cquca/nscscc_2018/soc_up/rtl/CONFREG/confreg.v

/*------------------------------------------------------------------------------
--------------------------------------------------------------------------------
Copyright (c) 2016, Loongson Technology Corporation Limited.

All rights reserved.

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
1. Redistributions of source code must retain the above copyright notice, this 
list of conditions and the following disclaimer.

2. Redistributions in binary form must reproduce the above copyright notice, 
this list of conditions and the following disclaimer in the documentation and/or
other materials provided with the distribution.

3. Neither the name of Loongson Technology Corporation Limited nor the names of 
its contributors may be used to endorse or promote products derived from this 
software without specific prior written permission.

THIS SOFTWARE IS PROVIDED BY THE COPYRIGHT HOLDERS AND CONTRIBUTORS "AS IS" AND 
ANY EXPRESS OR IMPLIED WARRANTIES, INCLUDING, BUT NOT LIMITED TO, THE IMPLIED 
WARRANTIES OF MERCHANTABILITY AND FITNESS FOR A PARTICULAR PURPOSE ARE 
DISCLAIMED. IN NO EVENT SHALL LOONGSON TECHNOLOGY CORPORATION LIMITED BE LIABLE
TO ANY PARTY FOR DIRECT, INDIRECT, INCIDENTAL, SPECIAL, EXEMPLARY, OR 
CONSEQUENTIAL DAMAGES (INCLUDING, BUT NOT LIMITED TO, PROCUREMENT OF SUBSTITUTE 
GOODS OR SERVICES; LOSS OF USE, DATA, OR PROFITS; OR BUSINESS INTERRUPTION) 
HOWEVER CAUSED AND ON ANY THEORY OF LIABILITY, WHETHER IN CONTRACT, STRICT 
LIABILITY, OR TORT (INCLUDING NEGLIGENCE OR OTHERWISE) ARISING IN ANY WAY OUT OF
THE USE OF THIS SOFTWARE, EVEN IF ADVISED OF THE POSSIBILITY OF SUCH DAMAGE.
--------------------------------------------------------------------------------
------------------------------------------------------------------------------*/

//*************************************************************************
//   > File Name   : confreg.v
//   > Description : Control module of 
//                   16 red leds, 2 green/red leds,
//                   7-segment display, 
//                   switchs, 
//                   key board,
//                   bottom STEP,
//                   timer.
//
//   > Author      : LOONGSON
//   > Date        : 2017-08-04
//*************************************************************************
`define RANDOM_SEED {7'b1010101,16'h0000}

`define CR0_ADDR       16'h8000   //32'hffff_8000 
`define CR1_ADDR       16'h8004   //32'hffff_8004 
`define CR2_ADDR       16'h8008   //32'hffff_8008 
`define CR3_ADDR       16'h800c   //32'hffff_800c 
`define CR4_ADDR       16'h8010   //32'hffff_8010 
`define CR5_ADDR       16'h8014   //32'hffff_8014 
`define CR6_ADDR       16'h8018   //32'hffff_8018 
`define CR7_ADDR       16'h801c   //32'hffff_801c 

`define LED_ADDR       16'hf000   //32'hffff_f000 
`define LED_RG0_ADDR   16'hf004   //32'hffff_f004 
`define LED_RG1_ADDR   16'hf008   //32'hffff_f008 
`define NUM_ADDR       16'hf010   //32'hffff_f010 
`define SWITCH_ADDR    16'hf020   //32'hffff_f020 
`define BTN_KEY_ADDR   16'hf024   //32'hffff_f024
`define BTN_STEP_ADDR  16'hf028   //32'hffff_f028
`define TIMER_ADDR     16'he000   //32'hffff_e000 

`define VIRTUAL_UART_ADDR 16'hfff0  //32'hffff_fff0
`define SIMU_FLAG_ADDR    16'hfff4  //32'hffff_fff4 
`define OPEN_TRACE_ADDR   16'hfff8  //32'hffff_fff8
`define NUM_MONITOR_ADDR  16'hfffc  //32'hffff_fffc
module confreg
#(parameter SIMULATION=1'b0)
(                     
    input             timer_clk,
    input             aclk,          
    input             aresetn,     
    // read and write from cpu
    //ar
    input  [3 :0] arid   ,
    input  [31:0] araddr ,
    input  [7 :0] arlen  ,
    input  [2 :0] arsize ,
    input  [1 :0] arburst,
    input  [1 :0] arlock ,
    input  [3 :0] arcache,
    input  [2 :0] arprot ,
    input         arvalid,
    output        arready,
    //r
    output [3 :0] rid    ,
    output [31:0] rdata  ,
    output [1 :0] rresp  ,
    output        rlast  ,
    output        rvalid ,
    input         rready ,
    //aw
    input  [3 :0] awid   ,
    input  [31:0] awaddr ,
    input  [7 :0] awlen  ,
    input  [2 :0] awsize ,
    input  [1 :0] awburst,
    input  [1 :0] awlock ,
    input  [3 :0] awcache,
    input  [2 :0] awprot ,
    input         awvalid,
    output        awready,
    //w
    input  [3 :0] wid    ,
    input  [31:0] wdata  ,
    input  [3 :0] wstrb  ,
    input         wlast  ,
    input         wvalid ,
    output        wready ,
    //b
    output [3 :0] bid    ,
    output [1 :0] bresp  ,
    output        bvalid ,
    input         bready ,

    //for lab6
    output     [4 :0] ram_random_mask  ,

    // read and write to device on board
    output     [15:0] led,          
    output     [1 :0] led_rg0,      
    output     [1 :0] led_rg1,      
    output reg [7 :0] num_csn,      
    output reg [6 :0] num_a_g,      
    input      [7 :0] switch,       
    output     [3 :0] btn_key_col,  
    input      [3 :0] btn_key_row,  
    input      [1 :0] btn_step      
);
    reg  [31:0] cr0;
    reg  [31:0] cr1;
    reg  [31:0] cr2;
    reg  [31:0] cr3;
    reg  [31:0] cr4;
    reg  [31:0] cr5;
    reg  [31:0] cr6;
    reg  [31:0] cr7;

    reg  [31:0] led_data;
    reg  [31:0] led_rg0_data;
    reg  [31:0] led_rg1_data;
    reg  [31:0] num_data;
    wire [31:0] switch_data;
    wire [31:0] btn_key_data;
    wire [31:0] btn_step_data;
    reg  [31:0] timer_r2;
    reg  [31:0] simu_flag;
    reg  [7 :0] virtual_uart_data;
    reg         open_trace;
    reg         num_monitor;
                        
//--------------------------{axi interface}begin-------------------------//
    reg busy,write,R_or_W;
    reg s_wready;

    wire ar_enter = arvalid & arready;
    wire r_retire = rvalid  & rready & rlast;
    wire aw_enter = awvalid & awready;
    wire w_enter  = wvalid  & wready & wlast;
    wire b_retire = bvalid  & bready;

    assign arready = ~busy & (!R_or_W| !awvalid);
    assign awready = ~busy & ( R_or_W| !arvalid);

    reg [3 :0] buf_id;
    reg [31:0] buf_addr;
    reg [7 :0] buf_len;
    reg [2 :0] buf_size;
    
    always @(posedge aclk)
    begin
        if(~aresetn) busy <= 1'b0;
        else if(ar_enter|aw_enter) busy <= 1'b1;
        else if(r_retire|b_retire) busy <= 1'b0;
    end
    
    always @(posedge aclk)
    begin
        if(~aresetn)
        begin
            R_or_W      <= 1'b0;
            buf_id      <= 4'b0;
            buf_addr    <= 32'b0;
            buf_len     <= 8'b0;
            buf_size    <= 3'b0;
        end
        else
        if(ar_enter | aw_enter)
        begin
            R_or_W      <= ar_enter;
            buf_id      <= ar_enter ? arid   : awid   ;
            buf_addr    <= ar_enter ? araddr : awaddr ;
            buf_len     <= ar_enter ? arlen  : awlen  ;
            buf_size    <= ar_enter ? arsize : awsize ;
        end
    end
    
    reg conf_wready_reg;
    assign wready = conf_wready_reg;
    always@(posedge aclk)
    begin
        if     (~aresetn       ) conf_wready_reg <= 1'b0;
        else if(aw_enter       ) conf_wready_reg <= 1'b1;
        else if(w_enter & wlast) conf_wready_reg <= 1'b0;
    end
    
    // read data has one cycle delay
    reg [31:0] conf_rdata_reg;
    reg        conf_rvalid_reg;
    reg        conf_rlast_reg;
    assign rdata  = conf_rdata_reg;
    assign rvalid = conf_rvalid_reg;
    assign rlast  = conf_rlast_reg;
    always @(posedge aclk)
    begin
        if(~aresetn)
        begin
            conf_rdata_reg  <= 32'd0;
            conf_rvalid_reg <= 1'd0;
            conf_rlast_reg  <= 1'd0;
        end
        else if(busy & R_or_W & !r_retire)
        begin
            conf_rvalid_reg <= 1'd1;
            conf_rlast_reg  <= 1'd1;
            case (buf_addr[15:0])
                `CR0_ADDR      : conf_rdata_reg <= cr0          ;
                `CR1_ADDR      : conf_rdata_reg <= cr1          ;
                `CR2_ADDR      : conf_rdata_reg <= cr2          ;
                `CR3_ADDR      : conf_rdata_reg <= cr3          ;
                `CR4_ADDR      : conf_rdata_reg <= cr4          ;
                `CR5_ADDR      : conf_rdata_reg <= cr5          ;
                `CR6_ADDR      : conf_rdata_reg <= cr6          ;
                `CR7_ADDR      : conf_rdata_reg <= cr7          ;
                `LED_ADDR      : conf_rdata_reg <= led_data     ;
                `LED_RG0_ADDR  : conf_rdata_reg <= led_rg0_data ;
                `LED_RG1_ADDR  : conf_rdata_reg <= led_rg1_data ;
                `NUM_ADDR      : conf_rdata_reg <= num_data     ;
                `SWITCH_ADDR   : conf_rdata_reg <= switch_data  ;
                `BTN_KEY_ADDR  : conf_rdata_reg <= btn_key_data ;
                `BTN_STEP_ADDR : conf_rdata_reg <= btn_step_data;
                `TIMER_ADDR    : conf_rdata_reg <= timer_r2     ;
                `SIMU_FLAG_ADDR: conf_rdata_reg <= simu_flag    ;
                `VIRTUAL_UART_ADDR : conf_rdata_reg <= {24'd0,virtual_uart_data} ;
                `OPEN_TRACE_ADDR : conf_rdata_reg <= {31'd0,open_trace} ;
                `NUM_MONITOR_ADDR: conf_rdata_reg <= {31'd0,num_monitor} ;
                default        : conf_rdata_reg <= 32'd0;
            endcase
        end
        else if(r_retire)
        begin
            conf_rvalid_reg <= 1'b0;
        end
    end

    //conf write, only support a word write
    wire        conf_we;
    wire [31:0] conf_addr;
    wire [31:0] conf_wdata;
    assign conf_we   = w_enter;
    assign conf_addr = buf_addr;
    assign conf_wdata= wdata;

    reg conf_bvalid_reg;
    assign bvalid = conf_bvalid_reg;
    always @(posedge aclk)   
    begin
        if     (~aresetn) conf_bvalid_reg <= 1'b0;
        else if(w_enter ) conf_bvalid_reg <= 1'b1;
        else if(b_retire) conf_bvalid_reg <= 1'b0;
    end

    assign rid   = buf_id;
    assign bid   = buf_id;
    assign bresp = 2'b0;
    assign rresp = 2'b0;
//---------------------------{axi interface}end--------------------------//

//-------------------------{confreg register}begin-----------------------//
wire write_cr0 = conf_we & (conf_addr[15:0]==`CR0_ADDR);
wire write_cr1 = conf_we & (conf_addr[15:0]==`CR1_ADDR);
wire write_cr2 = conf_we & (conf_addr[15:0]==`CR2_ADDR);
wire write_cr3 = conf_we & (conf_addr[15:0]==`CR3_ADDR);
wire write_cr4 = conf_we & (conf_addr[15:0]==`CR4_ADDR);
wire write_cr5 = conf_we & (conf_addr[15:0]==`CR5_ADDR);
wire write_cr6 = conf_we & (conf_addr[15:0]==`CR6_ADDR);
wire write_cr7 = conf_we & (conf_addr[15:0]==`CR7_ADDR);
always @(posedge aclk)
begin
    cr0 <= !aresetn    ? 32'd0      :
           write_cr0 ? conf_wdata : cr0;
    cr1 <= !aresetn    ? 32'd0      :
           write_cr1 ? conf_wdata : cr1;
    cr2 <= !aresetn    ? 32'd0      :
           write_cr2 ? conf_wdata : cr2;
    cr3 <= !aresetn    ? 32'd0      :
           write_cr3 ? conf_wdata : cr3;
    cr4 <= !aresetn    ? 32'd0      :
           write_cr4 ? conf_wdata : cr4;
    cr5 <= !aresetn    ? 32'd0      :
           write_cr5 ? conf_wdata : cr5;
    cr6 <= !aresetn    ? 32'd0      :
           write_cr6 ? conf_wdata : cr6;
    cr7 <= !aresetn    ? 32'd0      :
           write_cr7 ? conf_wdata : cr7;
end
//--------------------------{confreg register}end------------------------//

//-------------------------------{timer}begin----------------------------//
reg         write_timer_begin,write_timer_begin_r1, write_timer_begin_r2,write_timer_begin_r3;
reg         write_timer_end_r1, write_timer_end_r2;
reg  [31:0] conf_wdata_r, conf_wdata_r1,conf_wdata_r2;

reg  [31:0] timer_r1;
reg  [31:0] timer;

wire write_timer = conf_we & (conf_addr[15:0]==`TIMER_ADDR);
always @(posedge aclk)
begin
    if (!aresetn)
    begin
        write_timer_begin <= 1'b0;
    end 
    else if (write_timer)
    begin
        write_timer_begin <= 1'b1;
        conf_wdata_r      <= conf_wdata;
    end 
    else if (write_timer_end_r2)
    begin
        write_timer_begin <= 1'b0;
    end 

    write_timer_end_r1 <= write_timer_begin_r2;
    write_timer_end_r2 <= write_timer_end_r1;
end

always @(posedge timer_clk)
begin
    write_timer_begin_r1 <= write_timer_begin;
    write_timer_begin_r2 <= write_timer_begin_r1;
    write_timer_begin_r3 <= write_timer_begin_r2;
    conf_wdata_r1        <= conf_wdata_r;
    conf_wdata_r2        <= conf_wdata_r1;

    if(!aresetn)
    begin
        timer <= 32'd0;
    end
    else if (write_timer_begin_r2 && !write_timer_begin_r3)
    begin
        timer <= conf_wdata_r2[31:0];
    end
    else
    begin
        timer <= timer + 1'b1;
    end
end

always @(posedge aclk)
begin
    timer_r1 <= timer;
    timer_r2 <= timer_r1;
end
//--------------------------------{timer}end-----------------------------//

//--------------------------{simulation flag}begin-----------------------//
always @(posedge aclk)
begin
    if(!aresetn)
    begin
        simu_flag <= {32{SIMULATION}};
    end
end
//---------------------------{simulation flag}end------------------------//

//-----------------------------{open trace}begin-------------------------//
wire write_open_trace = conf_we & (conf_addr[15:0]==`OPEN_TRACE_ADDR);
always @(posedge aclk)
begin
    if(!aresetn)
    begin
        open_trace <= 1'b1;
    end
    else if(write_open_trace)
    begin
        open_trace <= conf_wdata[0];
    end
end
//-----------------------------{open trace}end---------------------------//

//----------------------------{num monitor}begin-------------------------//
wire write_num_monitor = conf_we & (conf_addr[15:0]==`NUM_MONITOR_ADDR);
always @(posedge aclk)
begin
    if(!aresetn)
    begin
        num_monitor <= 1'b1;
    end
    else if(write_num_monitor)
    begin
        num_monitor <= conf_wdata[0];
    end
end
//----------------------------{num monitor}end---------------------------//

//---------------------------{virtual uart}begin-------------------------//
wire [7:0] write_uart_data;
wire write_uart_valid  = conf_we & (conf_addr[15:0]==`VIRTUAL_UART_ADDR);
assign write_uart_data = conf_wdata[7:0];
always @(posedge aclk)
begin
    if(!aresetn)
    begin
        virtual_uart_data <= 8'd0;
    end
    else if(write_uart_valid)
    begin
        virtual_uart_data <= write_uart_data;
    end
end
//----------------------------{virtual uart}end--------------------------//

//--------------------------{axirandom mask}begin------------------------//
wire [15:0] led_r_n;
assign led_r_n = {~led[0],~led[1],~led[2],~led[3],
                  ~led[4],~led[5],~led[6],~led[7],
				  ~led[8],~led[9],~led[10],~led[11],
				  ~led[12],~led[13],~led[14],~led[15]};

reg [22:0] pseudo_random_23;
always @ (posedge aclk)
begin
   if (!aresetn || btn_step_data[0])
       //pseudo_random_23 <= simu_flag ? `RANDOM_SEED : {7'b1010101,led_r_n};
       pseudo_random_23 <= {7'b1010101,led_r_n};
   else
       pseudo_random_23 <= {pseudo_random_23[21:0],pseudo_random_23[22] ^ pseudo_random_23[17]};
end
assign ram_random_mask[0] = pseudo_random_23[10] & pseudo_random_23[20];
assign ram_random_mask[1] = pseudo_random_23[ 9] & pseudo_random_23[15];
assign ram_random_mask[2] = pseudo_random_23[ 8] ^ pseudo_random_23[22];
assign ram_random_mask[3] = pseudo_random_23[ 7] & pseudo_random_23[19];
assign ram_random_mask[4] = pseudo_random_23[ 6] ^ pseudo_random_23[16];

//---------------------------{axirandom mask}end-------------------------//

//--------------------------------{led}begin-----------------------------//
//led display
//led_data[31:0]
wire write_led = conf_we & (conf_addr[15:0]==`LED_ADDR);
//for lab6
//assign led = led_data[15:0];
assign led = {{2{switch[7]}},{2{switch[6]}},{2{switch[5]}},{2{switch[4]}},
              {2{switch[3]}},{2{switch[2]}},{2{switch[1]}},{2{switch[0]}}};
always @(posedge aclk)
begin
    if(!aresetn)
    begin
        led_data <= 32'h0;
    end
    else if(write_led)
    begin
        led_data <= conf_wdata[31:0];
    end
end
//---------------------------------{led}end------------------------------//

//-------------------------------{switch}begin---------------------------//
//switch data
//switch_data[7:0]
assign switch_data = {24'd0,switch};
//--------------------------------{switch}end----------------------------//

//------------------------------{btn key}begin---------------------------//
//btn key data
reg [15:0] btn_key_r;
assign btn_key_data = {16'd0,btn_key_r};

//state machine
reg  [2:0] state;
wire [2:0] next_state;

//eliminate jitter
reg        key_flag;
reg [19:0] key_count;
reg [ 3:0] state_count;
wire key_start = (state==3'b000) && !(&btn_key_row);
wire key_end   = (state==3'b111) &&  (&btn_key_row);
wire key_sample= key_count[19];
always @(posedge aclk)
begin
    if(!aresetn)
    begin
        key_flag <= 1'd0;
    end
    else if (key_sample && state_count[3]) 
    begin
        key_flag <= 1'b0;
    end
    else if( key_start || key_end )
    begin
        key_flag <= 1'b1;
    end

    if(!aresetn || !key_flag)
    begin
        key_count <= 20'd0;
    end
    else
    begin
        key_count <= key_count + 1'b1;
    end
end

always @(posedge aclk)
begin
    if(!aresetn || state_count[3])
    begin
        state_count <= 4'd0;
    end
    else
    begin
        state_count <= state_count + 1'b1;
    end
end

always @(posedge aclk)
begin
    if(!aresetn)
    begin
        state <= 3'b000;
    end
    else if (state_count[3])
    begin
        state <= next_state;
    end
end

assign next_state = (state == 3'b000) ? ( (key_sample && !(&btn_key_row)) ? 3'b001 : 3'b000 ) :
                    (state == 3'b001) ? (                !(&btn_key_row)  ? 3'b111 : 3'b010 ) :
                    (state == 3'b010) ? (                !(&btn_key_row)  ? 3'b111 : 3'b011 ) :
                    (state == 3'b011) ? (                !(&btn_key_row)  ? 3'b111 : 3'b100 ) :
                    (state == 3'b100) ? (                !(&btn_key_row)  ? 3'b111 : 3'b000 ) :
                    (state == 3'b111) ? ( (key_sample &&  (&btn_key_row)) ? 3'b000 : 3'b111 ) :
                                                                                        3'b000;
assign btn_key_col = (state == 3'b000) ? 4'b0000:
                     (state == 3'b001) ? 4'b1110:
                     (state == 3'b010) ? 4'b1101:
                     (state == 3'b011) ? 4'b1011:
                     (state == 3'b100) ? 4'b0111:
                                         4'b0000;
wire [15:0] btn_key_tmp;
always @(posedge aclk) begin
    if(!aresetn) begin
        btn_key_r   <= 16'd0;
    end
    else if(next_state==3'b000)
    begin
        btn_key_r   <=16'd0;
    end
    else if(next_state == 3'b111 && state != 3'b111) begin
        btn_key_r   <= btn_key_tmp;
    end
end

assign btn_key_tmp = (state == 3'b001)&(btn_key_row == 4'b1110) ? 16'h0001:
                     (state == 3'b001)&(btn_key_row == 4'b1101) ? 16'h0010:
                     (state == 3'b001)&(btn_key_row == 4'b1011) ? 16'h0100:
                     (state == 3'b001)&(btn_key_row == 4'b0111) ? 16'h1000:
                     (state == 3'b010)&(btn_key_row == 4'b1110) ? 16'h0002:
                     (state == 3'b010)&(btn_key_row == 4'b1101) ? 16'h0020:
                     (state == 3'b010)&(btn_key_row == 4'b1011) ? 16'h0200:
                     (state == 3'b010)&(btn_key_row == 4'b0111) ? 16'h2000:
                     (state == 3'b011)&(btn_key_row == 4'b1110) ? 16'h0004:
                     (state == 3'b011)&(btn_key_row == 4'b1101) ? 16'h0040:
                     (state == 3'b011)&(btn_key_row == 4'b1011) ? 16'h0400:
                     (state == 3'b011)&(btn_key_row == 4'b0111) ? 16'h4000:
                     (state == 3'b100)&(btn_key_row == 4'b1110) ? 16'h0008:
                     (state == 3'b100)&(btn_key_row == 4'b1101) ? 16'h0080:
                     (state == 3'b100)&(btn_key_row == 4'b1011) ? 16'h0800:
                     (state == 3'b100)&(btn_key_row == 4'b0111) ? 16'h8000:16'h0000;
//-------------------------------{btn key}end----------------------------//

//-----------------------------{btn step}begin---------------------------//
//btn step data
reg btn_step0_r; //0:press
reg btn_step1_r; //0:press
assign btn_step_data = {30'd0,~btn_step0_r,~btn_step1_r}; //1:press

//-----step0
//eliminate jitter
reg        step0_flag;
reg [19:0] step0_count;
wire step0_start = btn_step0_r && !btn_step[0];
wire step0_end   = !btn_step0_r && btn_step[0];
wire step0_sample= step0_count[19];
always @(posedge aclk)
begin
    if(!aresetn)
    begin
        step0_flag <= 1'd0;
    end
    else if (step0_sample) 
    begin
        step0_flag <= 1'b0;
    end
    else if( step0_start || step0_end )
    begin
        step0_flag <= 1'b1;
    end

    if(!aresetn || !step0_flag)
    begin
        step0_count <= 20'd0;
    end
    else
    begin
        step0_count <= step0_count + 1'b1;
    end

    if(!aresetn)
    begin
        btn_step0_r <= 1'b1;
    end
    else if(step0_sample)
    begin
        btn_step0_r <= btn_step[0];
    end
end

//-----step1
//eliminate jitter
reg        step1_flag;
reg [19:0] step1_count;
wire step1_start = btn_step1_r && !btn_step[1];
wire step1_end   = !btn_step1_r && btn_step[1];
wire step1_sample= step1_count[19];
always @(posedge aclk)
begin
    if(!aresetn)
    begin
        step1_flag <= 1'd0;
    end
    else if (step1_sample) 
    begin
        step1_flag <= 1'b0;
    end
    else if( step1_start || step1_end )
    begin
        step1_flag <= 1'b1;
    end

    if(!aresetn || !step1_flag)
    begin
        step1_count <= 20'd0;
    end
    else
    begin
        step1_count <= step1_count + 1'b1;
    end

    if(!aresetn)
    begin
        btn_step1_r <= 1'b1;
    end
    else if(step1_sample)
    begin
        btn_step1_r <= btn_step[1];
    end
end
//------------------------------{btn step}end----------------------------//

//-------------------------------{led rg}begin---------------------------//
//led_rg0_data[31:0]  led_rg0_data[31:0]
//bfd0_f010           bfd0_f014
wire write_led_rg0 = conf_we & (conf_addr[15:0]==`LED_RG0_ADDR);
wire write_led_rg1 = conf_we & (conf_addr[15:0]==`LED_RG1_ADDR);
assign led_rg0 = led_rg0_data[1:0];
assign led_rg1 = led_rg1_data[1:0];
always @(posedge aclk)
begin
    if(!aresetn)
    begin
        led_rg0_data <= 32'h0;
    end
    else if(write_led_rg0)
    begin
        led_rg0_data <= conf_wdata[31:0];
    end

    if(!aresetn)
    begin
        led_rg1_data <= 32'h0;
    end
    else if(write_led_rg1)
    begin
        led_rg1_data <= conf_wdata[31:0];
    end
end
//--------------------------------{led rg}end----------------------------//

//---------------------------{digital number}begin-----------------------//
//digital number display
//num_data[31:0]
wire write_num = conf_we & (conf_addr[15:0]==`NUM_ADDR);
always @(posedge aclk)
begin
    if(!aresetn)
    begin
        num_data <= 32'h0;
    end
    else if(write_num)
    begin
        num_data <= conf_wdata[31:0];
    end
end


reg [19:0] count;
always @(posedge aclk)
begin
    if(!aresetn)
    begin
        count <= 20'd0;
    end
    else
    begin
        count <= count + 1'b1;
    end
end
//scan data
reg [3:0] scan_data;
always @ ( posedge aclk )  
begin
    if ( !aresetn )
    begin
        scan_data <= 32'd0;  
        num_csn   <= 8'b1111_1111;
    end
    else
    begin
        case(count[19:17])
            3'b000 : scan_data <= num_data[31:28];
            3'b001 : scan_data <= num_data[27:24];
            3'b010 : scan_data <= num_data[23:20];
            3'b011 : scan_data <= num_data[19:16];
            3'b100 : scan_data <= num_data[15:12];
            3'b101 : scan_data <= num_data[11: 8];
            3'b110 : scan_data <= num_data[7 : 4];
            3'b111 : scan_data <= num_data[3 : 0];
        endcase

        case(count[19:17])
            3'b000 : num_csn <= 8'b0111_1111;
            3'b001 : num_csn <= 8'b1011_1111;
            3'b010 : num_csn <= 8'b1101_1111;
            3'b011 : num_csn <= 8'b1110_1111;
            3'b100 : num_csn <= 8'b1111_0111;
            3'b101 : num_csn <= 8'b1111_1011;
            3'b110 : num_csn <= 8'b1111_1101;
            3'b111 : num_csn <= 8'b1111_1110;
        endcase
    end
end

always @(posedge aclk)
begin
    if ( !aresetn )
    begin
        num_a_g <= 7'b0000000;
    end
    else
    begin
        case ( scan_data )
            4'd0 : num_a_g <= 7'b1111110;   //0
            4'd1 : num_a_g <= 7'b0110000;   //1
            4'd2 : num_a_g <= 7'b1101101;   //2
            4'd3 : num_a_g <= 7'b1111001;   //3
            4'd4 : num_a_g <= 7'b0110011;   //4
            4'd5 : num_a_g <= 7'b1011011;   //5
            4'd6 : num_a_g <= 7'b1011111;   //6
            4'd7 : num_a_g <= 7'b1110000;   //7
            4'd8 : num_a_g <= 7'b1111111;   //8
            4'd9 : num_a_g <= 7'b1111011;   //9
            4'd10: num_a_g <= 7'b1110111;   //a
            4'd11: num_a_g <= 7'b0011111;   //b
            4'd12: num_a_g <= 7'b1001110;   //c
            4'd13: num_a_g <= 7'b0111101;   //d
            4'd14: num_a_g <= 7'b1001111;   //e
            4'd15: num_a_g <= 7'b1000111;   //f
        endcase
    end
end
//----------------------------{digital number}end------------------------//
endmodule
