cquca/nscscc_2018/soft/memory_game/include/asm/asm.h

/*      $OpenBSD: asm.h,v 1.2 1998/03/16 09:03:02 pefo Exp $	*/

/*
 * Copyright (c) 1992, 1993
 *	The Regents of the University of California.  All rights reserved.
 *
 * This code is derived from software contributed to Berkeley by
 * Ralph Campbell.
 *
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
 *	Copyright (C) 1989 Digital Equipment Corporation.
 *	Permission to use, copy, modify, and distribute this software and
 *	its documentation for any purpose and without fee is hereby granted,
 *	provided that the above copyright notice appears in all copies.
 *	Digital Equipment Corporation makes no representations about the
 *	suitability of this software for any purpose.  It is provided "as is"
 *	without express or implied warranty.
 */

#ifndef _MIPS_ASM_H
#define _MIPS_ASM_H

#include <asm/regdef.h>

#ifndef ABICALLS
#define	ABICALLS	.abicalls
#endif

#if defined(ABICALLS) && !defined(_KERNEL)
	ABICALLS
#endif

#define RCSID(x)

/*
 * Define how to access unaligned data word 
 */
#if defined(__MIPSEL__)
#define LWLO    lwl
#define LWHI    lwr
#define	SWLO	swl
#define	SWHI	swr
#else
#if defined(__MIPSEB__)
#define LWLO    lwr
#define LWHI    lwl
#define	SWLO	swr
#define	SWHI	swl
#else
#error "__MIPSEL__ or __MIPSEB__ must be defined"
#endif
#endif

/*
 * Code for setting gp reg if abicalls are used.
 */
#if defined(ABICALLS) && !defined(_KERNEL)
#define	ABISETUP		\
	.set	noreorder;	\
	.cpload	t9;		\
	.set	reorder;
#else
#define	ABISETUP
#endif

/*
 * Define -pg profile entry code.
 */
#if defined(GPROF) || defined(PROF)
#define	MCOUNT			\
	subu 	sp, sp, 32;	\
	.cprestore 16;		\
	sw	ra, 28(sp);	\
	sw	gp, 24(sp);	\
	.set	noat;		\
	.set	noreorder;	\
	move	AT, ra;		\
	jal	_mcount;	\
	subu	sp, sp, 8;	\
	lw	ra, 28(sp);	\
	addu	sp, sp, 32;	\
	.set reorder;		\
	.set	at;
#else
#define	MCOUNT
#endif

/*
 * LEAF(x)
 *
 *	Declare a leaf routine.
 */
#define LEAF(x)			\
	.align	3;		\
	.globl x;		\
	.ent x, 0;		\
x: ;				\
	.frame sp, 0, ra;	\
	ABISETUP		\
	MCOUNT

#define	ALEAF(x)		\
	.globl	x;		\
x:

/*
 * NLEAF(x)
 *
 *	Declare a non-profiled leaf routine.
 */
#define NLEAF(x)		\
	.align	3;		\
	.globl x;		\
	.ent x, 0;		\
x: ;				\
	.frame sp, 0, ra;	\
	ABISETUP

/*
 * NON_LEAF(x)
 *
 *	Declare a non-leaf routine (a routine that makes other C calls).
 */
#define NON_LEAF(x, fsize, retpc) \
	.align	3;		\
	.globl x;		\
	.ent x, 0;		\
x: ;				\
	.frame sp, fsize, retpc; \
	ABISETUP		\
	MCOUNT

/*
 * NNON_LEAF(x)
 *
 *	Declare a non-profiled non-leaf routine
 *	(a routine that makes other C calls).
 */
#define NNON_LEAF(x, fsize, retpc) \
	.align	3;		\
	.globl x;		\
	.ent x, 0;		\
x: ;				\
	.frame sp, fsize, retpc	\
	ABISETUP

/*
 * END(x)
 *
 *	Mark end of a procedure.
 */
#define END(x) \
	.end x

/*
 * Macros to panic and printf from assembly language.
 */
#define PANIC(msg) \
	la	a0, 9f; \
	jal	panic; \
	MSG(msg)

#define	PRINTF(msg) \
	la	a0, 9f; \
	jal	printf; \
	MSG(msg)

#define	MSG(msg) \
	.rdata; \
9:	.asciiz	msg; \
	.text

#define ASMSTR(str) \
	.asciiz str; \
	.align	3

#if (_MIPS_SZPTR == 32)
#define PTR_ADD		add
#define PTR_ADDU	addu
#define PTR_ADDI	addi
#define PTR_ADDIU	addiu
#define PTR_SUB		sub
#define PTR_SUBU	subu
#define PTR_L		lw
#define PTR_S		sw
#define PTR_LA		la
#define PTR_LI		li
#define PTR_SLL		sll
#define PTR_SLLV	sllv
#define PTR_SRL		srl
#define PTR_SRLV	srlv
#define PTR_SRA		sra
#define PTR_SRAV	srav

#define PTR_SCALESHIFT	2

#define PTR		.word
#define PTRSIZE		4
#define PTRLOG		2
#endif

#if (_MIPS_SZPTR == 64)
#define PTR_ADD		dadd
#define PTR_ADDU	daddu
#define PTR_ADDI	daddi
#define PTR_ADDIU	daddiu
#define PTR_SUB		dsub
#define PTR_SUBU	dsubu
#define PTR_L		ld
#define PTR_S		sd
#define PTR_LA		dla
#define PTR_LI		dli
#define PTR_SLL		dsll
#define PTR_SLLV	dsllv
#define PTR_SRL		dsrl
#define PTR_SRLV	dsrlv
#define PTR_SRA		dsra
#define PTR_SRAV	dsrav

#define PTR_SCALESHIFT	3

#define PTR		.dword
#define PTRSIZE		8
#define PTRLOG		3
#endif

#endif /* !_MIPS_ASM_H */
