cquca/nscscc_2018/soc_up/rtl/myCPU/hilo_reg.v

`timescale 1ns / 1ps
//////////////////////////////////////////////////////////////////////////////////
// Company: 
// Engineer: 
// 
// Create Date: 2018/07/31 15:21:31
// Design Name: 
// Module Name: hilo_reg
// Project Name: 
// Target Devices: 
// Tool Versions: 
// Description: 
// 
// Dependencies: 
// 
// Revision:
// Revision 0.01 - File Created
// Additional Comments:
// 
//////////////////////////////////////////////////////////////////////////////////


module hilo_reg(
	input wire clk,rst,
	input wire[1:0] we,
	input wire[31:0] hi,lo,
	output wire [31:0]hi_o,lo_o
    );
	reg [31:0] hi_reg,lo_reg;
	always @(negedge clk) begin
		if(rst) begin
			hi_reg <= 0;
			lo_reg <= 0;
		end else begin 
			if(we[1]) hi_reg <= hi;
			if(we[0]) lo_reg <= lo;
		end
	end
	assign hi_o = hi_reg;
	assign lo_o = lo_reg;
endmodule
