cquca/nscscc_2018/soc_up/rtl/myCPU/i_cache.v

`timescale 1ns / 1ps
//////////////////////////////////////////////////////////////////////////////////
// Company: 
// Engineer: 
// 
// Create Date: 2018/07/28 09:21:49
// Design Name: 
// Module Name: i_cache
// Project Name: 
// Target Devices: 
// Tool Versions: 
// Description: 
// 
// Dependencies: 
// 
// Revision:
// Revision 0.01 - File Created
// Additional Comments:
// 
//////////////////////////////////////////////////////////////////////////////////


module i_cache#(parameter A_WIDTH = 32,
    parameter C_INDEX = 11)(
        input wire p_flush,
        input wire[A_WIDTH-1:0] p_a,
        output wire[31:0] p_din,
        input wire p_strobe,
        output wire p_ready,cache_miss,
        input wire clk,clrn,
        output wire[A_WIDTH-1:0] m_a,
        input wire[31:0] m_dout,
        output wire m_strobe,
        input wire m_ready

    );

    localparam T_WIDTH = A_WIDTH - C_INDEX - 2;
    reg d_valid [0:(1<<C_INDEX)-1];
    reg [T_WIDTH-1:0] d_tags [0:(1<<C_INDEX)-1];
    reg [7:0] d_data1 [0:(1<<C_INDEX)-1];
    reg [7:0] d_data2 [0:(1<<C_INDEX)-1];
    reg [7:0] d_data3 [0:(1<<C_INDEX)-1];
    reg [7:0] d_data4 [0:(1<<C_INDEX)-1];
    wire [C_INDEX-1:0] index = p_a[C_INDEX+1:2];
    wire [T_WIDTH-1:0] tag = p_a[A_WIDTH-1:C_INDEX+2];
    reg flush_ready;
    // read from cache
    wire valid = d_valid[index];
    wire [T_WIDTH-1:0] tagout = d_tags[index];
    wire [A_WIDTH-1:0] c_dout = {d_data1[index],d_data2[index],d_data3[index],d_data4[index]};


    // cache control 
    wire cache_hit = valid & (tagout == tag);
    assign cache_miss = ~cache_hit;
    assign m_a = p_a;
    assign m_strobe = p_strobe & cache_miss;
    assign p_ready = cache_hit | cache_miss & m_ready & ~flush_ready;
    wire c_write = cache_miss & m_ready;
    wire sel_out = cache_hit;
    wire [A_WIDTH-1:0] c_din = m_dout;
    assign p_din = sel_out? c_dout:m_dout;

    integer i;

    always @(posedge clk) begin
        if (~clrn) begin
            flush_ready <= 1'b0;
        end else if(m_ready) begin
            flush_ready <= 1'b0;
        end else if (p_flush) begin
            flush_ready <= 1'b1;
        end 
    end

    always @(posedge clk) begin
        if (clrn == 1'b0) begin
            
            for (i = 0; i<(1<<C_INDEX); i=i+1 ) begin
                d_valid[i] <= 1'b0;
            end 
        end else if (c_write & ~flush_ready) begin
                d_valid[index] <= 1'b1;
        end
      
    end

    always @(posedge clk) begin
        if (c_write & ~flush_ready) begin
            d_tags[index] <= tag;
            d_data1[index] <= c_din[31:24];
            d_data2[index] <= c_din[23:16];
            d_data3[index] <= c_din[15:8];
            d_data4[index] <= c_din[7:0];

        end
    end




endmodule
