cquca/nscscc_2018/soc_up/rtl/myCPU/pc.v

`timescale 1ns / 1ps
//////////////////////////////////////////////////////////////////////////////////
// Company: 
// Engineer: 
// 
// Create Date: 2017/11/26 21:25:26
// Design Name: 
// Module Name: pc
// Project Name: 
// Target Devices: 
// Tool Versions: 
// Description: 
// 
// Dependencies: 
// 
// Revision:
// Revision 0.01 - File Created
// Additional Comments:
// 
//////////////////////////////////////////////////////////////////////////////////


module pc #(parameter WIDTH = 32)(
	input wire clk,rst,en,clr,
	input wire[WIDTH-1:0] d,
	input wire[WIDTH-1:0] t,
	output reg[WIDTH-1:0] q
    );
	always @(posedge clk,posedge rst) begin
		if(rst) begin
			q <= 32'hbfc00000;
		end else if(clr) begin
                        /* code */
            q <= t;
        end else if(en) begin
			/* code */
			q <= d;
		end
	end
endmodule
