cquca/nscscc_2018/soc_up/rtl/myCPU/adder.v

`timescale 1ns / 1ps
//////////////////////////////////////////////////////////////////////////////////
// Company: 
// Engineer: 
// 
// Create Date: 2017/11/02 14:25:38
// Design Name: 
// Module Name: adder
// Project Name: 
// Target Devices: 
// Tool Versions: 
// Description: 
// 
// Dependencies: 
// 
// Revision:
// Revision 0.01 - File Created
// Additional Comments:
// 
//////////////////////////////////////////////////////////////////////////////////


module adder(
	input wire[31:0] a,b,
	output wire[31:0] y
    );

	assign y = a + b;
endmodule
