cquca/nscscc_2018/soc_up/rtl/myCPU/flopenrc.v

`timescale 1ns / 1ps
//////////////////////////////////////////////////////////////////////////////////
// Company: 
// Engineer: 
// 
// Create Date: 2017/11/22 09:59:26
// Design Name: 
// Module Name: flopenrc
// Project Name: 
// Target Devices: 
// Tool Versions: 
// Description: 
// 
// Dependencies: 
// 
// Revision:
// Revision 0.01 - File Created
// Additional Comments:
// 
//////////////////////////////////////////////////////////////////////////////////

//flip-flop with enable,rst,clear
module flopenrc #(parameter WIDTH = 8)(
	input wire clk,rst,en,clear,
	input wire[WIDTH-1:0] d,
	output reg[WIDTH-1:0] q
    );
	always @(posedge clk) begin
		if(rst) begin
			q <= 0;
		end else if(clear) begin
			q <= 0;
		end else if(en) begin
			/* code */
			q <= d;
		end
	end
endmodule
