cquca/nscscc_2018/soc_up/rtl/myCPU/sl2.v

`timescale 1ns / 1ps
//////////////////////////////////////////////////////////////////////////////////
// Company: 
// Engineer: 
// 
// Create Date: 2017/11/02 14:28:02
// Design Name: 
// Module Name: sl2
// Project Name: 
// Target Devices: 
// Tool Versions: 
// Description: 
// 
// Dependencies: 
// 
// Revision:
// Revision 0.01 - File Created
// Additional Comments:
// 
//////////////////////////////////////////////////////////////////////////////////


module sl2(
	input wire[31:0] a,
	output wire[31:0] y
    );

	assign y = {a[29:0],2'b00};
endmodule
