cquca/nscscc_2018/(commit log)

2018-07-30 aix interface test finished, read after write problem need fix
    [axi_interface.v, d_cache.v, datapath.v, hilo_reg.v, i_cache.v, mips.v, mips_top.v, mycpu_tb.v]
2018-07-31 try to fix priority problem
    [d_cache.v, mips_top.v, mycpu_tb.v]
2018-08-07 bug for stallreq_from_iram
2018-08-08 axi+cache pass 62, sb error casued by cache write
    [d_cache.v, i_cache.v]
2018-08-09 some errors for random delay test
    [confreg.v, d_cache.v]
2018-09-10 new .gitignore is now working
    [score.xls]
2018-09-10 do not ignore soft dir
    [score.xls]
